openbrickproject/BrickInterface/firmware/BrickInterface/BrickInterface.ino

// BrickInterface Firmware
// CH552T (TSSOP-20, ch55xduino)
//
// Supports:
//   - LEGO Interface A (6 outputs, 2 inputs)
//   - LEGO Power Functions IR (38 kHz)
//   - LEGO Legacy IR (76 kHz)
//   - LEGO RCX IR (38 kHz)

// USB CDC mode is selected via Arduino IDE Tools menu (boards.txt build flags),
// not via sketch macros. The descriptor (VID 0x1209, PID 0xc550 — pid.codes/ch55xduino)
// is hardcoded in the ch55xduino core and not user-overridable from the sketch.

#include "board_config.h"
#include "protocol.h"
#include "packet.h"
#include "ir_engine.h"
#include "interface_a.h"
#include "act_led.h"

#ifdef __SDCC
// Core USBCDC helper with no public prototype: blocks (250 ms timeout) until
// the armed EP2 IN transfer has been collected by the host. USBSerial_flush()
// only ARMS the transfer and returns immediately — it does not wait.
extern uint8_t USBSerial_wait_UpPoint2BusyFlag_clear(void);
#endif

// --- Capabilities for this board ---
#define DEVICE_CAPS (CAP_INTERFACE_A | CAP_PF_IR | CAP_LEGACY_IR | CAP_IR_DONE_EVENTS | CAP_RCX_IR)

// --- Packet parser ---
static PacketParser parser;

// --- Activity LED state (any-direction USB-CDC byte triggers a pulse) ---
#define ACT_LED_DURATION_MS 30
static unsigned long actLedOffMs = 0;

void actLedPulse(void) {
    digitalWrite(ACT_LED_PIN, HIGH);
    actLedOffMs = millis() + ACT_LED_DURATION_MS;
}

void actLedTick(void) {
    if (actLedOffMs && (long)(millis() - actLedOffMs) >= 0) {
        digitalWrite(ACT_LED_PIN, LOW);
        actLedOffMs = 0;
    }
}

// --- Forward declarations ---
static void handlePacket(const Packet *pkt);
static void drainIrCompletion(void);
static void doResetState(void);
static void enterBootloader(void);
static uint8_t isValidPFMode(uint8_t mode);
static uint8_t isValidLegacyNibble(uint8_t value);

// ============================================================
// Unified Timer 2 ISR — 76.92 kHz base tick (13 us), 153.85 kHz (6.5 us)
// while the Legacy engine transmits (see board_config.h).
//
// Three responsibilities, all run from the same vector:
//   (1) IR carrier toggle on P3.4
//       - carrierMode!=0: toggle every ISR — 38.46 kHz at the base tick
//         (PF, RCX), 76.92 kHz at the Legacy fast tick
//       - carrierMode=0: pin held low (spaces, idle)
//   (2) IR envelope state machine
//       - decrements envelopeTicks; when it hits 0, calls irNextPhase()
//         to load the next mark/space duration, or signals completion
//   (3) Interface A software PWM tick
//       - every 3rd ISR → 39 us tick → ~100 Hz PWM, 255-tick period
//         (so duty 255 = solid on, duty 0 = solid off)
//
// The whole body must finish within ~two tick periods or overflow flags
// are lost and the envelope stretches (the bug that broke RCX at 6.5 us).
//
// SDCC installs the Timer 2 vector via the weak Timer2Interrupt() in
// ch55xduino's core; our definition here overrides it at link time.
// (Timer 0 and Timer 1 have no equivalent hook from user code.)
// ============================================================
#define IFA_PRESCALE_MAX 3

static volatile __data uint8_t ifaPrescale = 0;

void Timer2Interrupt(void) __interrupt {
    TF2 = 0;  // Timer 2 overflow flag is not auto-cleared
    uint8_t phaseLoaded = 0;

    // (1) Carrier toggle — every tick; the frequency comes from the tick
    // rate, not a prescaler.
    if (carrierMode) {
        P3_4 = !P3_4;
    }

    // (2) Envelope phase progression
    if (envelopeTicks > 0) {
        if (--envelopeTicks == 0) {
            uint8_t cm;
            uint16_t ticks;
            phaseLoaded = 1;
            if (irNextPhase(&cm, &ticks)) {
                carrierMode = cm;
                if (cm == 0) P3_4 = 0;
                envelopeTicks = ticks;
            } else {
                // Transmission complete — irNextPhase already cleared
                // state.active and set the completion token/engine fields.
                carrierMode = 0;
                P3_4 = 0;
                completionPending = 1;
                // Back to the base tick in case this was a Legacy burst.
                RCAP2H = T2_RELOAD_BASE_H;
                RCAP2L = T2_RELOAD_BASE_L;
            }
        }
    }

    // (3) Interface A PWM (every 3rd ISR ≈ 39 us tick). Skipped on
    // phase-load ticks: a phase load plus six pin updates could overrun two
    // timer periods and lose a tick; a one-tick PWM hiccup once per IR
    // phase is invisible at 100 Hz.
    if (!phaseLoaded && ++ifaPrescale >= IFA_PRESCALE_MAX) {
        ifaPrescale = 0;
        // 255-tick period (counter runs 0..254) so duty 255 = always on and
        // duty 0 = always off; a 256-tick wrap would leave a notch at 255.
        uint8_t c = pwmCounter;
        if (++pwmCounter >= 255) pwmCounter = 0;
        P1_4 = (c < pwmDuty[0]) ? 1 : 0;
        P1_5 = (c < pwmDuty[1]) ? 1 : 0;
        P1_6 = (c < pwmDuty[2]) ? 1 : 0;
        P1_7 = (c < pwmDuty[3]) ? 1 : 0;
        P3_1 = (c < pwmDuty[4]) ? 1 : 0;
        P3_0 = (c < pwmDuty[5]) ? 1 : 0;
    }
}

// ============================================================
void setup() {
    // USB CDC needs no setup — ch55xduino brings it up automatically when
    // the "Default CDC" USB Settings option is selected. Baud rate is
    // meaningless on USB CDC.

    pinMode(ACT_LED_PIN, OUTPUT);
    digitalWrite(ACT_LED_PIN, LOW);
    pinMode(IR_LED_PIN, OUTPUT);
    digitalWrite(IR_LED_PIN, LOW);

    ifaceInit();   // starts Timer 2 at the 13 us base tick (shared with the IR engine)
    irInit();
    parserInit(&parser);
}

// ============================================================
void loop() {
    // Parse incoming packets
    while (USBSerial_available()) {
        uint8_t b = USBSerial_read();
        actLedPulse();
        parserConsume(&parser, b);
        if (parser.ready) {
            parser.ready = 0;
            handlePacket(&parser.pkt);
        }
    }

    // IR completion events
    drainIrCompletion();

    actLedTick();
    irPoll();
    ifaceEdgePoll();
}

// ============================================================
// Emit the queued IR completion event, if any. Called every loop() pass, and
// by the abort paths in handlePacket BEFORE they resolve another token:
// irAbortAll() writes through the single completion slot, so an undrained
// IR_DONE would otherwise be overwritten and lost.
static void drainIrCompletion(void) {
    uint8_t token, engine;
    if (irGetCompletion(&token, &engine)) {
        uint8_t payload[2] = { token, engine };
        sendReply(0x00, REPLY_IR_DONE, payload, 2);
    }
}

// ============================================================
// Command dispatch
// ============================================================
static void handlePacket(const Packet *pkt) {
    switch (pkt->cmd) {

    // --- Core ---
    case CMD_PING:
        sendReply(pkt->seq, REPLY_PONG, NULL, 0);
        break;

    case CMD_GET_VERSION: {
        uint8_t p[4] = { PROTO_VERSION_MAJOR, PROTO_VERSION_MINOR,
                         FW_VERSION_MAJOR, FW_VERSION_MINOR };
        sendReply(pkt->seq, REPLY_VERSION, p, 4);
        break;
    }

    case CMD_GET_CAPABILITIES: {
        uint16_t caps = DEVICE_CAPS;
        uint8_t p[2] = { (uint8_t)(caps & 0xFF), (uint8_t)(caps >> 8) };
        sendReply(pkt->seq, REPLY_CAPABILITIES, p, 2);
        break;
    }

    case CMD_RESET_STATE:
        drainIrCompletion();  // before the abort inside resolves another token
        doResetState();
        sendReply(pkt->seq, REPLY_OK, NULL, 0);
        break;

    case CMD_ENTER_BOOTLOADER:
        sendReply(pkt->seq, REPLY_OK, NULL, 0);
        // flush() only arms the EP2 IN transfer; wait for the host to
        // actually collect it before enterBootloader() tears USB down,
        // or the OK reply is lost.
        USBSerial_flush();
        USBSerial_wait_UpPoint2BusyFlag_clear();
        enterBootloader();
        break;

    // --- Interface A ---
    case CMD_IFACE_SET_OUTPUTS: {
        if (pkt->payload_len < 1) { sendError(pkt->seq, ERR_BAD_LENGTH, 0); break; }
        uint8_t mask = pkt->payload[0] & 0x3F;
        uint8_t expected = 1;
        for (uint8_t i = 0; i < 6; i++) {
            if (mask & (1 << i)) expected++;
        }
        if (pkt->payload_len != expected) { sendError(pkt->seq, ERR_BAD_LENGTH, 0); break; }
        ifaceSetOutputs(mask, pkt->payload + 1);
        sendReply(pkt->seq, REPLY_OK, NULL, 0);
        break;
    }

    case CMD_IFACE_GET_INPUTS: {
        uint8_t s = ifaceSampleInputs();
        sendReply(pkt->seq, REPLY_IFACE_INPUTS, &s, 1);
        break;
    }

    case CMD_IFACE_GET_COUNTS: {
        uint32_t c6 = ifaceGetCount(6);
        uint32_t c7 = ifaceGetCount(7);
        uint8_t p[8];
        p[0] = (uint8_t)(c6      ); p[1] = (uint8_t)(c6 >>  8);
        p[2] = (uint8_t)(c6 >> 16); p[3] = (uint8_t)(c6 >> 24);
        p[4] = (uint8_t)(c7      ); p[5] = (uint8_t)(c7 >>  8);
        p[6] = (uint8_t)(c7 >> 16); p[7] = (uint8_t)(c7 >> 24);
        sendReply(pkt->seq, REPLY_IFACE_COUNTS, p, 8);
        break;
    }

    case CMD_IFACE_RESET_COUNT: {
        if (pkt->payload_len != 1) { sendError(pkt->seq, ERR_BAD_LENGTH, 0); break; }
        if (pkt->payload[0] != 6 && pkt->payload[0] != 7) {
            sendError(pkt->seq, ERR_BAD_ARGUMENT, 0);
            break;
        }
        ifaceResetCount(pkt->payload[0]);
        sendReply(pkt->seq, REPLY_OK, NULL, 0);
        break;
    }

    // --- PF ---
    case CMD_PF_SEND: {
        if (pkt->payload_len != 4) { sendError(pkt->seq, ERR_BAD_LENGTH, 0); break; }
        if (pkt->payload[0] > 3 || !isValidPFMode(pkt->payload[1])) {
            sendError(pkt->seq, ERR_BAD_ARGUMENT, 0);
            break;
        }
        uint8_t tok = irStartPF(pkt->payload[0], pkt->payload[1],
                                pkt->payload[2], pkt->payload[3]);
        if (!tok) { sendError(pkt->seq, ERR_BUSY, 0); break; }
        uint8_t p[2] = { tok, IR_ENGINE_PF };
        sendReply(pkt->seq, REPLY_IR_ACCEPTED, p, 2);
        break;
    }

    // --- Legacy ---
    case CMD_LEGACY_SEND: {
        if (pkt->payload_len != 3) { sendError(pkt->seq, ERR_BAD_LENGTH, 0); break; }
        if (pkt->payload[0] < 4 || pkt->payload[0] > 7 ||
            !isValidLegacyNibble(pkt->payload[1]) || !isValidLegacyNibble(pkt->payload[2])) {
            sendError(pkt->seq, ERR_BAD_ARGUMENT, 0);
            break;
        }
        uint8_t tok = irStartLegacy(pkt->payload[0], pkt->payload[1], pkt->payload[2]);
        if (!tok) { sendError(pkt->seq, ERR_BUSY, 0); break; }
        uint8_t p[2] = { tok, IR_ENGINE_LEGACY };
        sendReply(pkt->seq, REPLY_IR_ACCEPTED, p, 2);
        break;
    }

    // --- RCX ---
    case CMD_RCX_SEND: {
        if (pkt->payload_len < 2) { sendError(pkt->seq, ERR_BAD_LENGTH, 0); break; }
        if ((pkt->payload_len - 1) > 16) { sendError(pkt->seq, ERR_BAD_ARGUMENT, 0); break; }
        uint8_t tok = irStartRCX(&pkt->payload[1], pkt->payload_len - 1, pkt->payload[0]);
        if (!tok) { sendError(pkt->seq, ERR_BUSY, 0); break; }
        uint8_t p[2] = { tok, IR_ENGINE_RCX };
        sendReply(pkt->seq, REPLY_IR_ACCEPTED, p, 2);
        break;
    }

    case CMD_RCX_SEND_RAW: {
        if (pkt->payload_len < 2) { sendError(pkt->seq, ERR_BAD_LENGTH, 0); break; }
        if ((pkt->payload_len - 1) > RCX_MAX_FRAMED_BYTES) { sendError(pkt->seq, ERR_BAD_ARGUMENT, 0); break; }
        uint8_t tok = irStartRCXRaw(&pkt->payload[1], pkt->payload_len - 1, pkt->payload[0]);
        if (!tok) { sendError(pkt->seq, ERR_BUSY, 0); break; }
        uint8_t p[2] = { tok, IR_ENGINE_RCX };
        sendReply(pkt->seq, REPLY_IR_ACCEPTED, p, 2);
        break;
    }

    // --- IR abort ---
    case CMD_IR_ABORT_ALL:
        drainIrCompletion();  // before irAbortAll resolves another token
        irAbortAll();
        sendReply(pkt->seq, REPLY_OK, NULL, 0);
        break;

    default:
        sendError(pkt->seq, ERR_UNKNOWN_CMD, 0);
        break;
    }
}

// ============================================================
static uint8_t isValidPFMode(uint8_t mode) {
    switch (mode) {
        case PF_MODE_COMBO_DIRECT:
        case PF_MODE_SINGLE_PWM:
        case PF_MODE_SINGLE_CST:
        case PF_MODE_COMBO_PWM:
            return 1;
        default:
            return 0;
    }
}

static uint8_t isValidLegacyNibble(uint8_t value) {
    return value <= 0x0F;
}

// ============================================================
static void doResetState(void) {
    ifaceClearAllOutputs();
    ifaceResetCount(6);
    ifaceResetCount(7);
    irAbortAll();
    pfToggle[0] = pfToggle[1] = pfToggle[2] = pfToggle[3] = 0;
}

// ============================================================
// Jump to CH552 ROM bootloader (entry at 0x3800).
// Tear down USB so the host re-enumerates the WCH bootloader VID/PID,
// disable interrupts, then long-jump into ROM.
static void enterBootloader(void) {
    // Halt active peripherals before tearing down USB and jumping to ROM.
    irAbortAll();
    ifaceClearAllOutputs();
    USB_INT_EN = 0;
    USB_CTRL = 0;
    UDEV_CTRL = 0;       // detach from bus
    delay(100);          // let host see the disconnect
    EA = 0;              // disable all interrupts
#ifdef __SDCC
    __asm__("ljmp #0x3800");
#endif
}
