openbrickproject/BrickInterface/firmware/BrickInterface/interface_a.h

#ifndef INTERFACE_A_H
#define INTERFACE_A_H

#include <stdint.h>
#include <Arduino.h>   // __data/__xdata qualifiers (ch55xduino on target, stub in tests)
#include "board_config.h"

void ifaceInit(void);

// PWM state shared with the unified Timer 2 ISR. The ISR itself lives in the
// .ino translation unit (SDCC vector installation requirement) and accesses
// these.
extern volatile __xdata uint8_t pwmDuty[6];
extern volatile __data    uint8_t pwmCounter;

// Apply PWM duties to selected outputs. `mask` bit i set = apply the next
// packed duty byte to output i; bit clear = leave that output untouched.
// `packed_duties` contains exactly popcount(mask) bytes, one per set bit,
// in ascending bit order. Pass mask=0x3F with six bytes to update all six.
void ifaceSetOutputs(uint8_t mask, const uint8_t *packed_duties);

// Force all outputs to 0 (used by RESET_STATE and bootloader entry).
void ifaceClearAllOutputs(void);

// Read both input pin levels. Returns bit 0 = input 6, bit 1 = input 7.
// Pulled-up = HIGH = open = Logo "false".
uint8_t ifaceSampleInputs(void);

// Debounce window for the edge counters: a raw level change must hold this
// long (ms) before it becomes the debounced state and can count. Filters
// mechanical switch bounce (touch sensors) on both press and release. The
// inputs have no hardware RC filtering, so this is the only debounce.
#define IFACE_DEBOUNCE_MS 10

// Edge counters for inputs 6 and 7.
// Counts only false-to-true transitions in the LEGO TC Logo sense — i.e.
// the wire pin going from HIGH (open / pullup) to LOW (closed / dark / pressed).
// Transitions are debounced (IFACE_DEBOUNCE_MS); a bouncing contact counts once.
//
// `ifaceEdgePoll()` must be called from the main loop on every iteration.
// `input` is the wire-level port number: 6 or 7.
void ifaceEdgePoll(void);
uint32_t ifaceGetCount(uint8_t input);
void ifaceResetCount(uint8_t input);

#endif
