openbrickproject/BrickInterface/firmware/BrickInterface/tests/test_dispatch.cpp

// Layer 2 — command-dispatch tests.
//
// Covers the handler-level reply framing and the validation paths
// (CMD_PF_SEND with bad mode, CMD_LEGACY_SEND with bad nibbles,
// CMD_RCX_SEND too long, IR busy, etc.). Exercises BrickInterface.ino
// directly by including it after pulling in the other firmware sources.
#include "test_harness.h"
#include "../packet.c"
#include "../ir_engine.c"
#include "../interface_a.c"
#include "../BrickInterface.ino"

// ---------------------------------------------------------------------------
// Helpers
// ---------------------------------------------------------------------------

static void reset_capture(void) {
    Serial.tx_len = 0;
}

static void make_packet(Packet *pkt, uint8_t seq, uint8_t cmd,
                        const uint8_t *payload, uint8_t len) {
    pkt->seq = seq;
    pkt->cmd = cmd;
    pkt->payload_len = len;
    if (payload && len) memcpy(pkt->payload, payload, len);
}

// Decode the reply frame starting at offset `pos` in the Serial capture.
// Returns the offset of the next frame, or 0 if no valid frame is there.
static uint16_t decode_frame_at(uint16_t pos, uint8_t *seq, uint8_t *cmd,
                                uint8_t *payload, uint8_t *payload_len) {
    if (Serial.tx_len < (uint16_t)(pos + 5)) return 0;
    if (Serial.tx_buf[pos] != 0xAA) return 0;
    uint8_t len = Serial.tx_buf[pos + 1];
    if (Serial.tx_len < (uint16_t)(pos + 2 + len + 1)) return 0;
    *seq = Serial.tx_buf[pos + 2];
    *cmd = Serial.tx_buf[pos + 3];
    *payload_len = len - 2;
    if (*payload_len) memcpy(payload, &Serial.tx_buf[pos + 4], *payload_len);
    // Verify checksum
    uint8_t chk = len ^ *seq ^ *cmd;
    for (uint8_t i = 0; i < *payload_len; i++) chk ^= payload[i];
    if (chk != Serial.tx_buf[pos + 2 + len]) return 0;
    return pos + 2 + len + 1;
}

// Decode the first reply frame from Serial capture into seq/cmd/payload[].
// Returns 1 if a valid frame was found, 0 otherwise.
static uint8_t decode_first_reply(uint8_t *seq, uint8_t *cmd,
                                  uint8_t *payload, uint8_t *payload_len) {
    return decode_frame_at(0, seq, cmd, payload, payload_len) != 0;
}

// Drive one debounced level transition on a counter input: present the new
// raw level, advance the fake clock past the debounce window, poll again to
// commit it.
static void settle_edge(uint8_t idx, uint8_t level) {
    ifaceCountEdge(idx, level);
    test_now_ms += IFACE_DEBOUNCE_MS + 1;
    ifaceCountEdge(idx, level);
}

// Reset firmware state between tests to keep them independent.
static void reset_firmware_state(void) {
    irAbortAll();
    pending.valid = 0;
    state.active = IR_ACTIVE_NONE;
    completionPending = 0;  // irAbortAll resolves outstanding tokens; drop the event
    pfToggle[0] = pfToggle[1] = pfToggle[2] = pfToggle[3] = 0;
    test_reset_pin_state();
    reset_capture();
}

// ---------------------------------------------------------------------------
// Core commands
// ---------------------------------------------------------------------------

TEST(dispatch_ping_replies_pong) {
    reset_firmware_state();
    Packet pkt;
    make_packet(&pkt, 0x5A, CMD_PING, NULL, 0);
    handlePacket(&pkt);

    uint8_t seq, cmd, payload[32], plen;
    ASSERT_EQ(decode_first_reply(&seq, &cmd, payload, &plen), 1);
    ASSERT_EQ(seq, 0x5A);
    ASSERT_EQ(cmd, REPLY_PONG);
    ASSERT_EQ(plen, 0);
}

TEST(dispatch_get_version_returns_4_bytes) {
    reset_firmware_state();
    Packet pkt;
    make_packet(&pkt, 0x01, CMD_GET_VERSION, NULL, 0);
    handlePacket(&pkt);

    uint8_t seq, cmd, payload[32], plen;
    ASSERT_EQ(decode_first_reply(&seq, &cmd, payload, &plen), 1);
    ASSERT_EQ(cmd, REPLY_VERSION);
    ASSERT_EQ(plen, 4);
    ASSERT_EQ(payload[0], PROTO_VERSION_MAJOR);
    ASSERT_EQ(payload[1], PROTO_VERSION_MINOR);
}

TEST(dispatch_get_capabilities_includes_interface_a) {
    reset_firmware_state();
    Packet pkt;
    make_packet(&pkt, 0x02, CMD_GET_CAPABILITIES, NULL, 0);
    handlePacket(&pkt);

    uint8_t seq, cmd, payload[32], plen;
    ASSERT_EQ(decode_first_reply(&seq, &cmd, payload, &plen), 1);
    ASSERT_EQ(cmd, REPLY_CAPABILITIES);
    ASSERT_EQ(plen, 2);
    uint16_t caps = payload[0] | (payload[1] << 8);
    ASSERT_TRUE(caps & CAP_INTERFACE_A);
    ASSERT_TRUE(caps & CAP_PF_IR);
    ASSERT_TRUE(caps & CAP_LEGACY_IR);
    ASSERT_TRUE(caps & CAP_RCX_IR);
}

TEST(dispatch_unknown_cmd_returns_error) {
    reset_firmware_state();
    Packet pkt;
    make_packet(&pkt, 0x99, 0xFF /*not a real cmd*/, NULL, 0);
    handlePacket(&pkt);

    uint8_t seq, cmd, payload[32], plen;
    ASSERT_EQ(decode_first_reply(&seq, &cmd, payload, &plen), 1);
    ASSERT_EQ(cmd, REPLY_ERROR);
    ASSERT_EQ(payload[0], ERR_UNKNOWN_CMD);
}

// ---------------------------------------------------------------------------
// Interface A
// ---------------------------------------------------------------------------

TEST(dispatch_iface_set_outputs_all_six_replies_ok) {
    reset_firmware_state();
    Packet pkt;
    // Payload = mask (all six outputs) + one packed duty byte per set bit.
    uint8_t p[7] = {0x3F, 10, 20, 30, 40, 50, 60};
    make_packet(&pkt, 0x10, CMD_IFACE_SET_OUTPUTS, p, 7);
    handlePacket(&pkt);

    uint8_t seq, cmd, payload[32], plen;
    ASSERT_EQ(decode_first_reply(&seq, &cmd, payload, &plen), 1);
    ASSERT_EQ(cmd, REPLY_OK);
    for (uint8_t i = 0; i < 6; i++) ASSERT_EQ(pwmDuty[i], 10 * (i + 1));
}

TEST(dispatch_iface_set_outputs_mask_applies_selectively) {
    reset_firmware_state();
    // Pre-seed all duties to a known value so we can verify mask leaves
    // some outputs untouched.
    uint8_t base[6] = {99, 99, 99, 99, 99, 99};
    ifaceSetOutputs(0x3F, base);

    Packet pkt;
    uint8_t p[3] = {0x05, 11, 33};  // mask = outputs 0 and 2 only
    make_packet(&pkt, 0x11, CMD_IFACE_SET_OUTPUTS, p, 3);
    handlePacket(&pkt);

    uint8_t seq, cmd, payload[32], plen;
    ASSERT_EQ(decode_first_reply(&seq, &cmd, payload, &plen), 1);
    ASSERT_EQ(cmd, REPLY_OK);
    ASSERT_EQ(pwmDuty[0], 11);
    ASSERT_EQ(pwmDuty[1], 99);
    ASSERT_EQ(pwmDuty[2], 33);
    ASSERT_EQ(pwmDuty[3], 99);
    ASSERT_EQ(pwmDuty[4], 99);
    ASSERT_EQ(pwmDuty[5], 99);
}

TEST(dispatch_iface_set_outputs_bad_length_errors) {
    reset_firmware_state();
    Packet pkt;
    make_packet(&pkt, 0x12, CMD_IFACE_SET_OUTPUTS, NULL, 0);
    handlePacket(&pkt);

    uint8_t seq, cmd, payload[32], plen;
    ASSERT_EQ(decode_first_reply(&seq, &cmd, payload, &plen), 1);
    ASSERT_EQ(cmd, REPLY_ERROR);
    ASSERT_EQ(payload[0], ERR_BAD_LENGTH);
}

TEST(dispatch_iface_set_outputs_duty_count_mismatch_errors) {
    reset_firmware_state();
    Packet pkt;
    uint8_t p[2] = {0x05, 1};  // mask selects 2 outputs but only 1 duty byte
    make_packet(&pkt, 0x14, CMD_IFACE_SET_OUTPUTS, p, 2);
    handlePacket(&pkt);

    uint8_t seq, cmd, payload[32], plen;
    ASSERT_EQ(decode_first_reply(&seq, &cmd, payload, &plen), 1);
    ASSERT_EQ(cmd, REPLY_ERROR);
    ASSERT_EQ(payload[0], ERR_BAD_LENGTH);
}

TEST(dispatch_iface_get_inputs_returns_one_byte) {
    reset_firmware_state();
    Packet pkt;
    make_packet(&pkt, 0x13, CMD_IFACE_GET_INPUTS, NULL, 0);
    handlePacket(&pkt);

    uint8_t seq, cmd, payload[32], plen;
    ASSERT_EQ(decode_first_reply(&seq, &cmd, payload, &plen), 1);
    ASSERT_EQ(cmd, REPLY_IFACE_INPUTS);
    ASSERT_EQ(plen, 1);
    // Only bits 0 and 1 are meaningful; upper bits zero.
    ASSERT_EQ(payload[0] & 0xFC, 0);
}

// ---------------------------------------------------------------------------
// Interface A — counter commands
// ---------------------------------------------------------------------------

TEST(dispatch_iface_get_counts_returns_8_bytes) {
    reset_firmware_state();
    ifaceResetCount(6); ifaceResetCount(7);
    Packet pkt;
    make_packet(&pkt, 0x30, CMD_IFACE_GET_COUNTS, NULL, 0);
    handlePacket(&pkt);

    uint8_t seq, cmd, payload[32], plen;
    ASSERT_EQ(decode_first_reply(&seq, &cmd, payload, &plen), 1);
    ASSERT_EQ(cmd, REPLY_IFACE_COUNTS);
    ASSERT_EQ(plen, 8);
    // Both counters start at zero.
    for (int i = 0; i < 8; i++) ASSERT_EQ(payload[i], 0);
}

TEST(dispatch_iface_get_counts_reflects_edge_increments) {
    reset_firmware_state();
    ifaceResetCount(6); ifaceResetCount(7);
    // Three false->true edges on input 6 (idx 0): high, low, high, low, high, low
    settle_edge(0, 1);  // baseline high — no count
    settle_edge(0, 0);  // edge 1
    settle_edge(0, 1);
    settle_edge(0, 0);  // edge 2
    settle_edge(0, 1);
    settle_edge(0, 0);  // edge 3

    Packet pkt;
    make_packet(&pkt, 0x31, CMD_IFACE_GET_COUNTS, NULL, 0);
    handlePacket(&pkt);

    uint8_t seq, cmd, payload[32], plen;
    ASSERT_EQ(decode_first_reply(&seq, &cmd, payload, &plen), 1);
    ASSERT_EQ(cmd, REPLY_IFACE_COUNTS);
    // Little-endian u32: count6 = 3, count7 = 0.
    ASSERT_EQ(payload[0], 3);
    ASSERT_EQ(payload[1], 0);
    ASSERT_EQ(payload[2], 0);
    ASSERT_EQ(payload[3], 0);
    ASSERT_EQ(payload[4], 0);
}

TEST(dispatch_iface_reset_count_zeros_one_port) {
    reset_firmware_state();
    ifaceResetCount(6); ifaceResetCount(7);
    // Increment both inputs.
    settle_edge(0, 1); settle_edge(0, 0);
    settle_edge(1, 1); settle_edge(1, 0);

    Packet pkt;
    uint8_t p[] = {6};
    make_packet(&pkt, 0x32, CMD_IFACE_RESET_COUNT, p, 1);
    handlePacket(&pkt);

    uint8_t seq, cmd, payload[32], plen;
    ASSERT_EQ(decode_first_reply(&seq, &cmd, payload, &plen), 1);
    ASSERT_EQ(cmd, REPLY_OK);

    // Confirm: input 6 is zero, input 7 is unchanged.
    ASSERT_EQ(ifaceGetCount(6), 0);
    ASSERT_EQ(ifaceGetCount(7), 1);
}

TEST(dispatch_iface_reset_count_bad_input_errors) {
    reset_firmware_state();
    Packet pkt;
    uint8_t p[] = {5};  // input 5 doesn't exist (only 6 and 7)
    make_packet(&pkt, 0x33, CMD_IFACE_RESET_COUNT, p, 1);
    handlePacket(&pkt);

    uint8_t seq, cmd, payload[32], plen;
    ASSERT_EQ(decode_first_reply(&seq, &cmd, payload, &plen), 1);
    ASSERT_EQ(cmd, REPLY_ERROR);
    ASSERT_EQ(payload[0], ERR_BAD_ARGUMENT);
}

TEST(dispatch_iface_reset_count_bad_length_errors) {
    reset_firmware_state();
    Packet pkt;
    make_packet(&pkt, 0x34, CMD_IFACE_RESET_COUNT, NULL, 0);
    handlePacket(&pkt);

    uint8_t seq, cmd, payload[32], plen;
    ASSERT_EQ(decode_first_reply(&seq, &cmd, payload, &plen), 1);
    ASSERT_EQ(cmd, REPLY_ERROR);
    ASSERT_EQ(payload[0], ERR_BAD_LENGTH);
}

TEST(dispatch_reset_state_zeros_counters) {
    reset_firmware_state();
    settle_edge(0, 1); settle_edge(0, 0);
    settle_edge(1, 1); settle_edge(1, 0);

    Packet pkt;
    make_packet(&pkt, 0x36, CMD_RESET_STATE, NULL, 0);
    handlePacket(&pkt);

    ASSERT_EQ(ifaceGetCount(6), 0);
    ASSERT_EQ(ifaceGetCount(7), 0);
}

TEST(iface_counter_debounces_contact_bounce) {
    reset_firmware_state();
    ifaceResetCount(6); ifaceResetCount(7);
    settle_edge(0, 1);  // idle high (open)

    // Press with contact bounce: rapid H->L->H->L flips inside the debounce
    // window must register as ONE count once the level finally holds low.
    ifaceCountEdge(0, 0);
    test_now_ms += 1; ifaceCountEdge(0, 1);
    test_now_ms += 1; ifaceCountEdge(0, 0);
    test_now_ms += 1; ifaceCountEdge(0, 1);
    test_now_ms += 1; ifaceCountEdge(0, 0);
    test_now_ms += IFACE_DEBOUNCE_MS + 1;
    ifaceCountEdge(0, 0);
    ASSERT_EQ(ifaceGetCount(6), 1);

    // Release with bounce: rising edges never count, and the bounce's brief
    // low dips must not count either.
    ifaceCountEdge(0, 1);
    test_now_ms += 1; ifaceCountEdge(0, 0);
    test_now_ms += 1; ifaceCountEdge(0, 1);
    test_now_ms += IFACE_DEBOUNCE_MS + 1;
    ifaceCountEdge(0, 1);
    ASSERT_EQ(ifaceGetCount(6), 1);

    // Next clean press counts again.
    settle_edge(0, 0);
    ASSERT_EQ(ifaceGetCount(6), 2);
}

// ---------------------------------------------------------------------------
// PF — invalid mode rejection (the regression we just guarded)
// ---------------------------------------------------------------------------

TEST(dispatch_pf_send_rejects_invalid_mode) {
    reset_firmware_state();
    Packet pkt;
    uint8_t p[] = {0 /*ch*/, 0xFF /*invalid mode*/, 0, 0};
    make_packet(&pkt, 0x20, CMD_PF_SEND, p, 4);
    handlePacket(&pkt);

    uint8_t seq, cmd, payload[32], plen;
    ASSERT_EQ(decode_first_reply(&seq, &cmd, payload, &plen), 1);
    ASSERT_EQ(cmd, REPLY_ERROR);
    ASSERT_EQ(payload[0], ERR_BAD_ARGUMENT);
}

TEST(dispatch_pf_send_rejects_bad_channel) {
    // Channel > 3 must be ERR_BAD_ARGUMENT per PROTOCOL.md — it used to
    // fall through to the engine and surface as ERR_BUSY.
    reset_firmware_state();
    Packet pkt;
    uint8_t p[] = {4 /*invalid ch*/, PF_MODE_COMBO_DIRECT, 0x01, 0x01};
    make_packet(&pkt, 0x24, CMD_PF_SEND, p, 4);
    handlePacket(&pkt);

    uint8_t seq, cmd, payload[32], plen;
    ASSERT_EQ(decode_first_reply(&seq, &cmd, payload, &plen), 1);
    ASSERT_EQ(cmd, REPLY_ERROR);
    ASSERT_EQ(payload[0], ERR_BAD_ARGUMENT);
}

TEST(dispatch_pf_send_accepts_valid_mode) {
    reset_firmware_state();
    Packet pkt;
    uint8_t p[] = {0, PF_MODE_COMBO_DIRECT, 0x01, 0x01};
    make_packet(&pkt, 0x21, CMD_PF_SEND, p, 4);
    handlePacket(&pkt);

    uint8_t seq, cmd, payload[32], plen;
    ASSERT_EQ(decode_first_reply(&seq, &cmd, payload, &plen), 1);
    ASSERT_EQ(cmd, REPLY_IR_ACCEPTED);
    ASSERT_EQ(plen, 2);
    ASSERT_EQ(payload[1], IR_ENGINE_PF);
}

TEST(dispatch_pf_send_busy_returns_error) {
    reset_firmware_state();
    Packet pkt;
    uint8_t p[] = {0, PF_MODE_COMBO_DIRECT, 0x01, 0x01};

    // First send: accepted
    make_packet(&pkt, 0x22, CMD_PF_SEND, p, 4);
    handlePacket(&pkt);

    // Second send while first is still pending: BUSY
    reset_capture();
    make_packet(&pkt, 0x23, CMD_PF_SEND, p, 4);
    handlePacket(&pkt);

    uint8_t seq, cmd, payload[32], plen;
    ASSERT_EQ(decode_first_reply(&seq, &cmd, payload, &plen), 1);
    ASSERT_EQ(cmd, REPLY_ERROR);
    ASSERT_EQ(payload[0], ERR_BUSY);
}

// ---------------------------------------------------------------------------
// Legacy — invalid nibble rejection
// ---------------------------------------------------------------------------

TEST(dispatch_legacy_send_rejects_orange_out_of_range) {
    reset_firmware_state();
    Packet pkt;
    uint8_t p[] = {4 /*ch*/, 0x10 /*invalid nibble, > 0x0F*/, 0x00};
    make_packet(&pkt, 0x30, CMD_LEGACY_SEND, p, 3);
    handlePacket(&pkt);

    uint8_t seq, cmd, payload[32], plen;
    ASSERT_EQ(decode_first_reply(&seq, &cmd, payload, &plen), 1);
    ASSERT_EQ(cmd, REPLY_ERROR);
    ASSERT_EQ(payload[0], ERR_BAD_ARGUMENT);
}

TEST(dispatch_legacy_send_rejects_yellow_out_of_range) {
    reset_firmware_state();
    Packet pkt;
    uint8_t p[] = {4, 0x07, 0xF0 /*invalid nibble*/};
    make_packet(&pkt, 0x31, CMD_LEGACY_SEND, p, 3);
    handlePacket(&pkt);

    uint8_t seq, cmd, payload[32], plen;
    ASSERT_EQ(decode_first_reply(&seq, &cmd, payload, &plen), 1);
    ASSERT_EQ(cmd, REPLY_ERROR);
    ASSERT_EQ(payload[0], ERR_BAD_ARGUMENT);
}

TEST(dispatch_legacy_send_accepts_valid_nibbles) {
    reset_firmware_state();
    Packet pkt;
    uint8_t p[] = {4, 0x07, 0x08};
    make_packet(&pkt, 0x32, CMD_LEGACY_SEND, p, 3);
    handlePacket(&pkt);

    uint8_t seq, cmd, payload[32], plen;
    ASSERT_EQ(decode_first_reply(&seq, &cmd, payload, &plen), 1);
    ASSERT_EQ(cmd, REPLY_IR_ACCEPTED);
    ASSERT_EQ(payload[1], IR_ENGINE_LEGACY);
}

TEST(dispatch_legacy_send_rejects_bad_channel_code) {
    // channelCode must be 4-7; out-of-range used to surface as ERR_BUSY.
    reset_firmware_state();
    Packet pkt;
    uint8_t seq, cmd, payload[32], plen;

    uint8_t low[] = {3, 0x07, 0x08};
    make_packet(&pkt, 0x33, CMD_LEGACY_SEND, low, 3);
    handlePacket(&pkt);
    ASSERT_EQ(decode_first_reply(&seq, &cmd, payload, &plen), 1);
    ASSERT_EQ(cmd, REPLY_ERROR);
    ASSERT_EQ(payload[0], ERR_BAD_ARGUMENT);

    reset_capture();
    uint8_t high[] = {8, 0x07, 0x08};
    make_packet(&pkt, 0x34, CMD_LEGACY_SEND, high, 3);
    handlePacket(&pkt);
    ASSERT_EQ(decode_first_reply(&seq, &cmd, payload, &plen), 1);
    ASSERT_EQ(cmd, REPLY_ERROR);
    ASSERT_EQ(payload[0], ERR_BAD_ARGUMENT);
}

// ---------------------------------------------------------------------------
// RCX — oversized payload rejection
// ---------------------------------------------------------------------------

TEST(dispatch_rcx_send_rejects_too_long) {
    reset_firmware_state();
    Packet pkt;
    // carrier_mode + 17 data bytes — exceeds 16-byte data limit
    uint8_t p[18] = {0};
    make_packet(&pkt, 0x40, CMD_RCX_SEND, p, 18);
    handlePacket(&pkt);

    uint8_t seq, cmd, payload[32], plen;
    ASSERT_EQ(decode_first_reply(&seq, &cmd, payload, &plen), 1);
    ASSERT_EQ(cmd, REPLY_ERROR);
    ASSERT_EQ(payload[0], ERR_BAD_ARGUMENT);
}

TEST(dispatch_rcx_send_raw_rejects_too_long) {
    reset_firmware_state();
    Packet pkt;
    // carrier byte + 38 raw bytes — exceeds RCX_MAX_FRAMED_BYTES (37)
    uint8_t p[39] = {0};
    make_packet(&pkt, 0x42, CMD_RCX_SEND_RAW, p, 39);
    handlePacket(&pkt);

    uint8_t seq, cmd, payload[32], plen;
    ASSERT_EQ(decode_first_reply(&seq, &cmd, payload, &plen), 1);
    ASSERT_EQ(cmd, REPLY_ERROR);
    ASSERT_EQ(payload[0], ERR_BAD_ARGUMENT);
}

TEST(dispatch_rcx_send_raw_accepts_full_frame) {
    // A fully-framed 16-data-byte RCX packet is 37 raw bytes; with the
    // 40-byte payload cap it now fits (carrier byte + 37 = 38).
    reset_firmware_state();
    Packet pkt;
    uint8_t p[38] = {0};
    make_packet(&pkt, 0x43, CMD_RCX_SEND_RAW, p, 38);
    handlePacket(&pkt);

    uint8_t seq, cmd, payload[32], plen;
    ASSERT_EQ(decode_first_reply(&seq, &cmd, payload, &plen), 1);
    ASSERT_EQ(cmd, REPLY_IR_ACCEPTED);
    ASSERT_EQ(payload[1], IR_ENGINE_RCX);
}

TEST(dispatch_rcx_send_accepts_valid) {
    reset_firmware_state();
    Packet pkt;
    uint8_t p[] = {0 /*carrier_mode*/, 0x12 /*data*/};
    make_packet(&pkt, 0x41, CMD_RCX_SEND, p, 2);
    handlePacket(&pkt);

    uint8_t seq, cmd, payload[32], plen;
    ASSERT_EQ(decode_first_reply(&seq, &cmd, payload, &plen), 1);
    ASSERT_EQ(cmd, REPLY_IR_ACCEPTED);
    ASSERT_EQ(payload[1], IR_ENGINE_RCX);
}

// ---------------------------------------------------------------------------
// IR control
// ---------------------------------------------------------------------------

TEST(dispatch_ir_abort_all_replies_ok) {
    reset_firmware_state();
    Packet pkt;
    make_packet(&pkt, 0x50, CMD_IR_ABORT_ALL, NULL, 0);
    handlePacket(&pkt);

    uint8_t seq, cmd, payload[32], plen;
    ASSERT_EQ(decode_first_reply(&seq, &cmd, payload, &plen), 1);
    ASSERT_EQ(cmd, REPLY_OK);
}

TEST(dispatch_ir_abort_emits_ir_done_for_aborted_send) {
    reset_firmware_state();
    Packet pkt;
    uint8_t p[] = {0, PF_MODE_COMBO_DIRECT, 0x01, 0x01};
    make_packet(&pkt, 0x51, CMD_PF_SEND, p, 4);
    handlePacket(&pkt);

    uint8_t seq, cmd, payload[32], plen;
    ASSERT_EQ(decode_first_reply(&seq, &cmd, payload, &plen), 1);
    ASSERT_EQ(cmd, REPLY_IR_ACCEPTED);
    uint8_t token = payload[0];

    reset_capture();
    make_packet(&pkt, 0x52, CMD_IR_ABORT_ALL, NULL, 0);
    handlePacket(&pkt);
    ASSERT_EQ(decode_first_reply(&seq, &cmd, payload, &plen), 1);
    ASSERT_EQ(cmd, REPLY_OK);

    // The aborted request's token still resolves with exactly one IR_DONE.
    uint8_t t, e;
    ASSERT_EQ(irGetCompletion(&t, &e), 1);
    ASSERT_EQ(t, token);
    ASSERT_EQ(e, IR_ENGINE_PF);
    ASSERT_EQ(irGetCompletion(&t, &e), 0);
}

// Run the accepted request through the engine to completion, leaving its
// IR_DONE queued but undrained — what the Timer 2 ISR produces when a burst
// finishes before loop() gets to the drain step.
static void run_burst_to_completion(void) {
    irPoll();  // pending -> active
    uint8_t cm; uint16_t ticks;
    while (irNextPhase(&cm, &ticks)) { /* consume all envelope phases */ }
    completionPending = 1;  // what the ISR does when irNextPhase returns 0
}

// Regression: a completed-but-undrained IR_DONE must survive an abort that
// resolves another token in the same parse batch (it used to be overwritten
// in the single completion slot and lost).
TEST(dispatch_abort_preserves_undrained_completion) {
    reset_firmware_state();
    Packet pkt;
    uint8_t p[] = {0, PF_MODE_COMBO_DIRECT, 0x01, 0x01};
    uint8_t seq, cmd, payload[32], plen;

    // Burst A: accepted and fully transmitted; completion not yet drained.
    make_packet(&pkt, 0x60, CMD_PF_SEND, p, 4);
    handlePacket(&pkt);
    ASSERT_EQ(decode_first_reply(&seq, &cmd, payload, &plen), 1);
    ASSERT_EQ(cmd, REPLY_IR_ACCEPTED);
    uint8_t tokenA = payload[0];
    run_burst_to_completion();

    // Same parse batch: a new send, then IR_ABORT_ALL.
    reset_capture();
    make_packet(&pkt, 0x61, CMD_PF_SEND, p, 4);
    handlePacket(&pkt);
    uint16_t pos = decode_frame_at(0, &seq, &cmd, payload, &plen);
    ASSERT_TRUE(pos != 0);
    ASSERT_EQ(cmd, REPLY_IR_ACCEPTED);
    uint8_t tokenB = payload[0];

    make_packet(&pkt, 0x62, CMD_IR_ABORT_ALL, NULL, 0);
    handlePacket(&pkt);

    // The abort handler must emit A's IR_DONE before resolving B's token...
    pos = decode_frame_at(pos, &seq, &cmd, payload, &plen);
    ASSERT_TRUE(pos != 0);
    ASSERT_EQ(cmd, REPLY_IR_DONE);
    ASSERT_EQ(seq, 0x00);
    ASSERT_EQ(payload[0], tokenA);

    pos = decode_frame_at(pos, &seq, &cmd, payload, &plen);
    ASSERT_TRUE(pos != 0);
    ASSERT_EQ(cmd, REPLY_OK);

    // ...and B's token resolves through the completion slot as usual.
    uint8_t t, e;
    ASSERT_EQ(irGetCompletion(&t, &e), 1);
    ASSERT_EQ(t, tokenB);
    ASSERT_EQ(irGetCompletion(&t, &e), 0);
}

// Same scenario through CMD_RESET_STATE, which aborts via doResetState().
TEST(dispatch_reset_state_preserves_undrained_completion) {
    reset_firmware_state();
    Packet pkt;
    uint8_t p[] = {0, PF_MODE_COMBO_DIRECT, 0x01, 0x01};
    uint8_t seq, cmd, payload[32], plen;

    make_packet(&pkt, 0x70, CMD_PF_SEND, p, 4);
    handlePacket(&pkt);
    ASSERT_EQ(decode_first_reply(&seq, &cmd, payload, &plen), 1);
    uint8_t tokenA = payload[0];
    run_burst_to_completion();

    reset_capture();
    make_packet(&pkt, 0x71, CMD_PF_SEND, p, 4);
    handlePacket(&pkt);
    uint16_t pos = decode_frame_at(0, &seq, &cmd, payload, &plen);
    ASSERT_TRUE(pos != 0);
    uint8_t tokenB = payload[0];

    make_packet(&pkt, 0x72, CMD_RESET_STATE, NULL, 0);
    handlePacket(&pkt);

    pos = decode_frame_at(pos, &seq, &cmd, payload, &plen);
    ASSERT_TRUE(pos != 0);
    ASSERT_EQ(cmd, REPLY_IR_DONE);
    ASSERT_EQ(payload[0], tokenA);

    pos = decode_frame_at(pos, &seq, &cmd, payload, &plen);
    ASSERT_TRUE(pos != 0);
    ASSERT_EQ(cmd, REPLY_OK);

    uint8_t t, e;
    ASSERT_EQ(irGetCompletion(&t, &e), 1);
    ASSERT_EQ(t, tokenB);
    ASSERT_EQ(irGetCompletion(&t, &e), 0);
}

int main(void) {
    RUN_ALL_TESTS();
}
