openbrickproject/BrickInterface/(commit log)

2026-05-21 fix: PF IR and IFA working
    [BrickInterface.ino, interface_a.c, ir_engine.c, ir_engine.h]
2026-05-22 chore: tidy repo
    [BrickInterface.kicad_pcb, BrickInterface.kicad_sch, bom.csv, designators.csv, positions.csv]
2026-06-07 fix: sw1 to 3.3
    [BrickInterface.kicad_pcb, BrickInterface.kicad_sch]
2026-06-12 fix: fixes, tests, and cleanup
    [BrickInterface.kicad_pcb]
2026-07-29 chore: purchase button, test, fixes
    [Arduino.h, BrickInterface.ino, interface_a.c, interface_a.h, ir_engine.c, protocol.h, test_dispatch.cpp]
